vaovao1jp/pico-QRP-CW-LSB-Transceiver/pico_CW_LSB_TRX.pdf

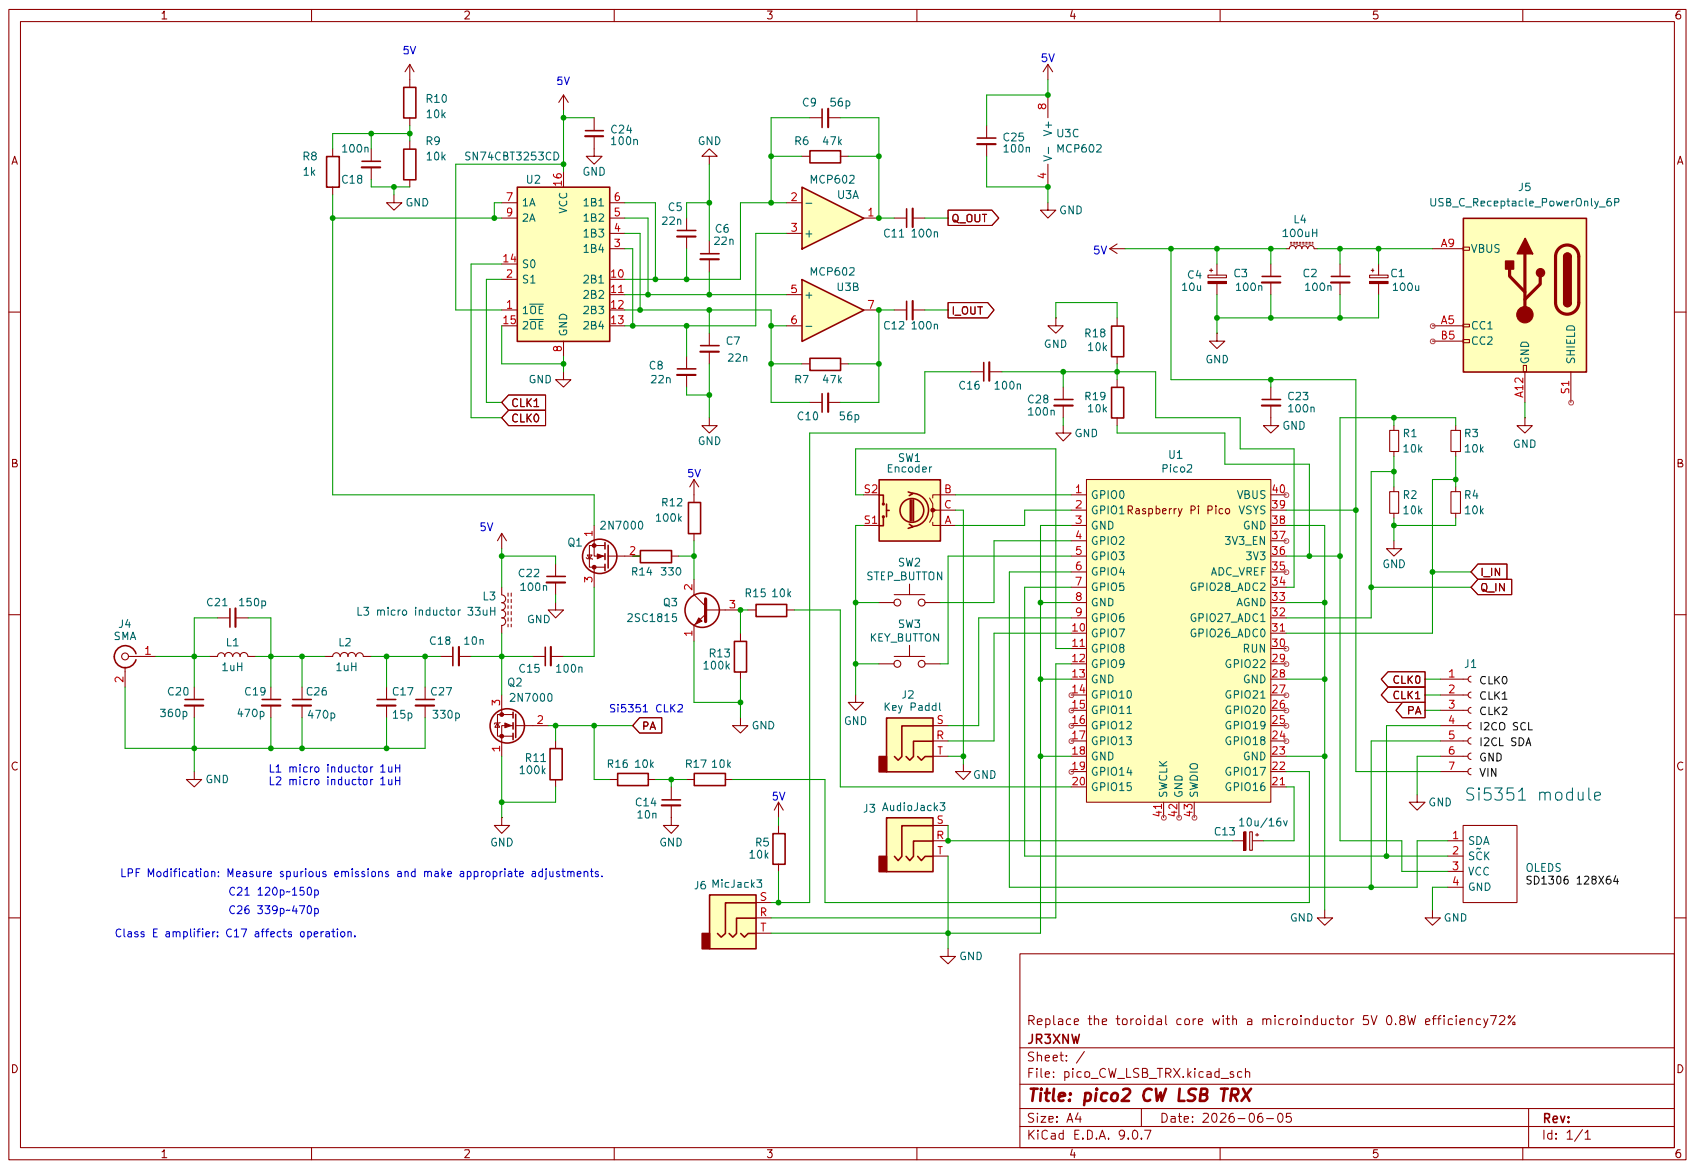
[picture p1: page 1]
